aRebootIsAlwaysGood/open-heatpump/documents/code_documentation_html/structDI__STATES__coll__graph.png

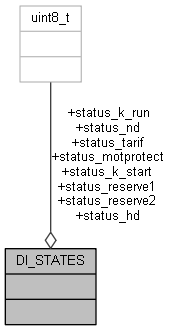
documents/code_documentation_html/structDI__STATES__coll__graph.png
