aRebootIsAlwaysGood/open-heatpump/documents/code_documentation_html/structHEIZKURVE__coll__graph.png

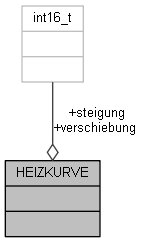
documents/code_documentation_html/structHEIZKURVE__coll__graph.png
