aRebootIsAlwaysGood/open-heatpump/documents/code_documentation_html/structSETTINGS__coll__graph.png

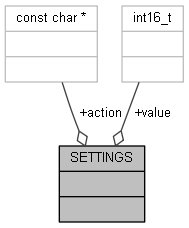
documents/code_documentation_html/structSETTINGS__coll__graph.png
