aRebootIsAlwaysGood/open-heatpump/documents/code_documentation_html/structSYSTEMZUSTAND__coll__graph.png

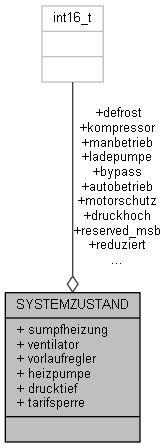
documents/code_documentation_html/structSYSTEMZUSTAND__coll__graph.png
