aRebootIsAlwaysGood/open-heatpump/documents/code_documentation_html/wpAuto_8h_afed4915ead06746e4c683ee93642d8cb_cgraph.png

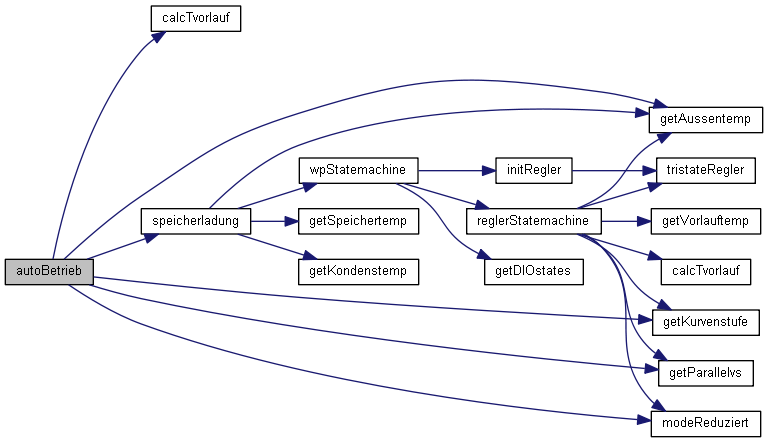
documents/code_documentation_html/wpAuto_8h_afed4915ead06746e4c683ee93642d8cb_cgraph.png
