aRebootIsAlwaysGood/open-heatpump/documents/code_documentation_html/wpControl_8h_ae710165b7dd2b053ad08f96dba48d54c_cgraph.png

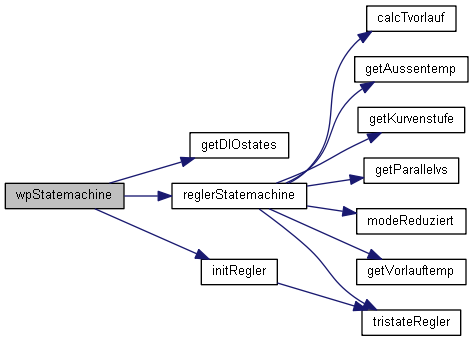
documents/code_documentation_html/wpControl_8h_ae710165b7dd2b053ad08f96dba48d54c_cgraph.png
