aRebootIsAlwaysGood/open-heatpump/documents/code_documentation_html/wpMain_8ino_afe461d27b9c48d5921c00d521181f12f_cgraph.png

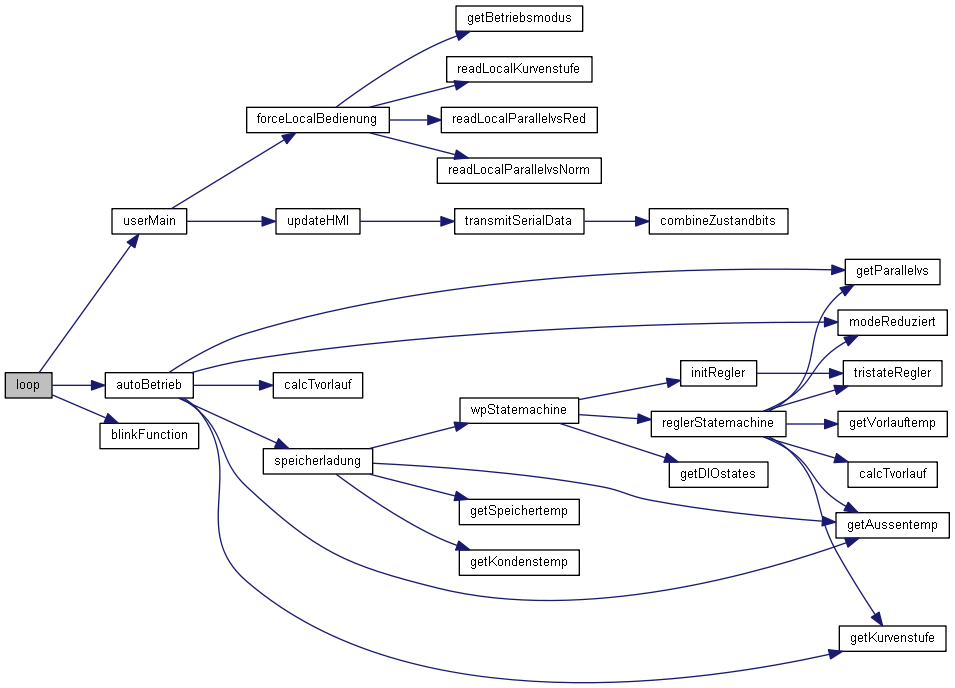
documents/code_documentation_html/wpMain_8ino_afe461d27b9c48d5921c00d521181f12f_cgraph.png
