aRebootIsAlwaysGood/open-heatpump/documents/code_documentation_html/wpRegler_8h_a802a6ca104db722b268f0693497b7094_cgraph.png

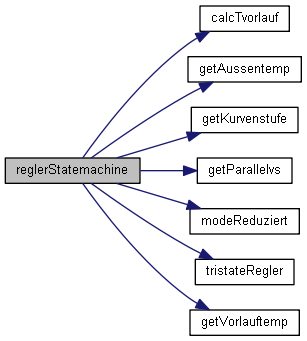
documents/code_documentation_html/wpRegler_8h_a802a6ca104db722b268f0693497b7094_cgraph.png
