aRebootIsAlwaysGood/open-heatpump/documents/code_documentation_html/wpSpeicherladung_8h_a1c0cf0ef9357ae514777ada14e9a8edd_cgraph.png

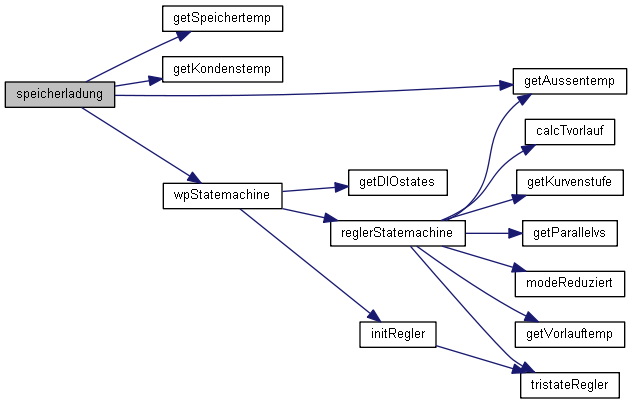
documents/code_documentation_html/wpSpeicherladung_8h_a1c0cf0ef9357ae514777ada14e9a8edd_cgraph.png
