aRebootIsAlwaysGood/open-heatpump/documents/code_documentation_html/wpUser_8h_a805e7a62053643fc56378e3905329b2b_cgraph.png

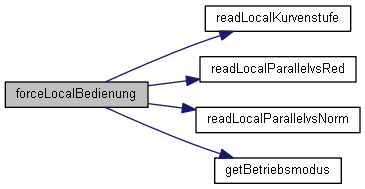
documents/code_documentation_html/wpUser_8h_a805e7a62053643fc56378e3905329b2b_cgraph.png
