aRebootIsAlwaysGood/open-heatpump/documents/code_documentation_html/wpUser_8h_ab3d6a2608aa113517ff811539024869a_cgraph.png

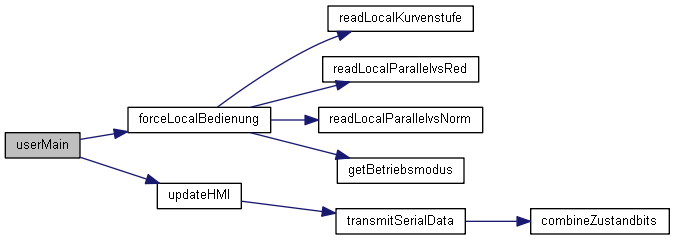
documents/code_documentation_html/wpUser_8h_ab3d6a2608aa113517ff811539024869a_cgraph.png
