aRebootIsAlwaysGood/open-heatpump/documents/Schema_Grundsteuerung_SW.pdf

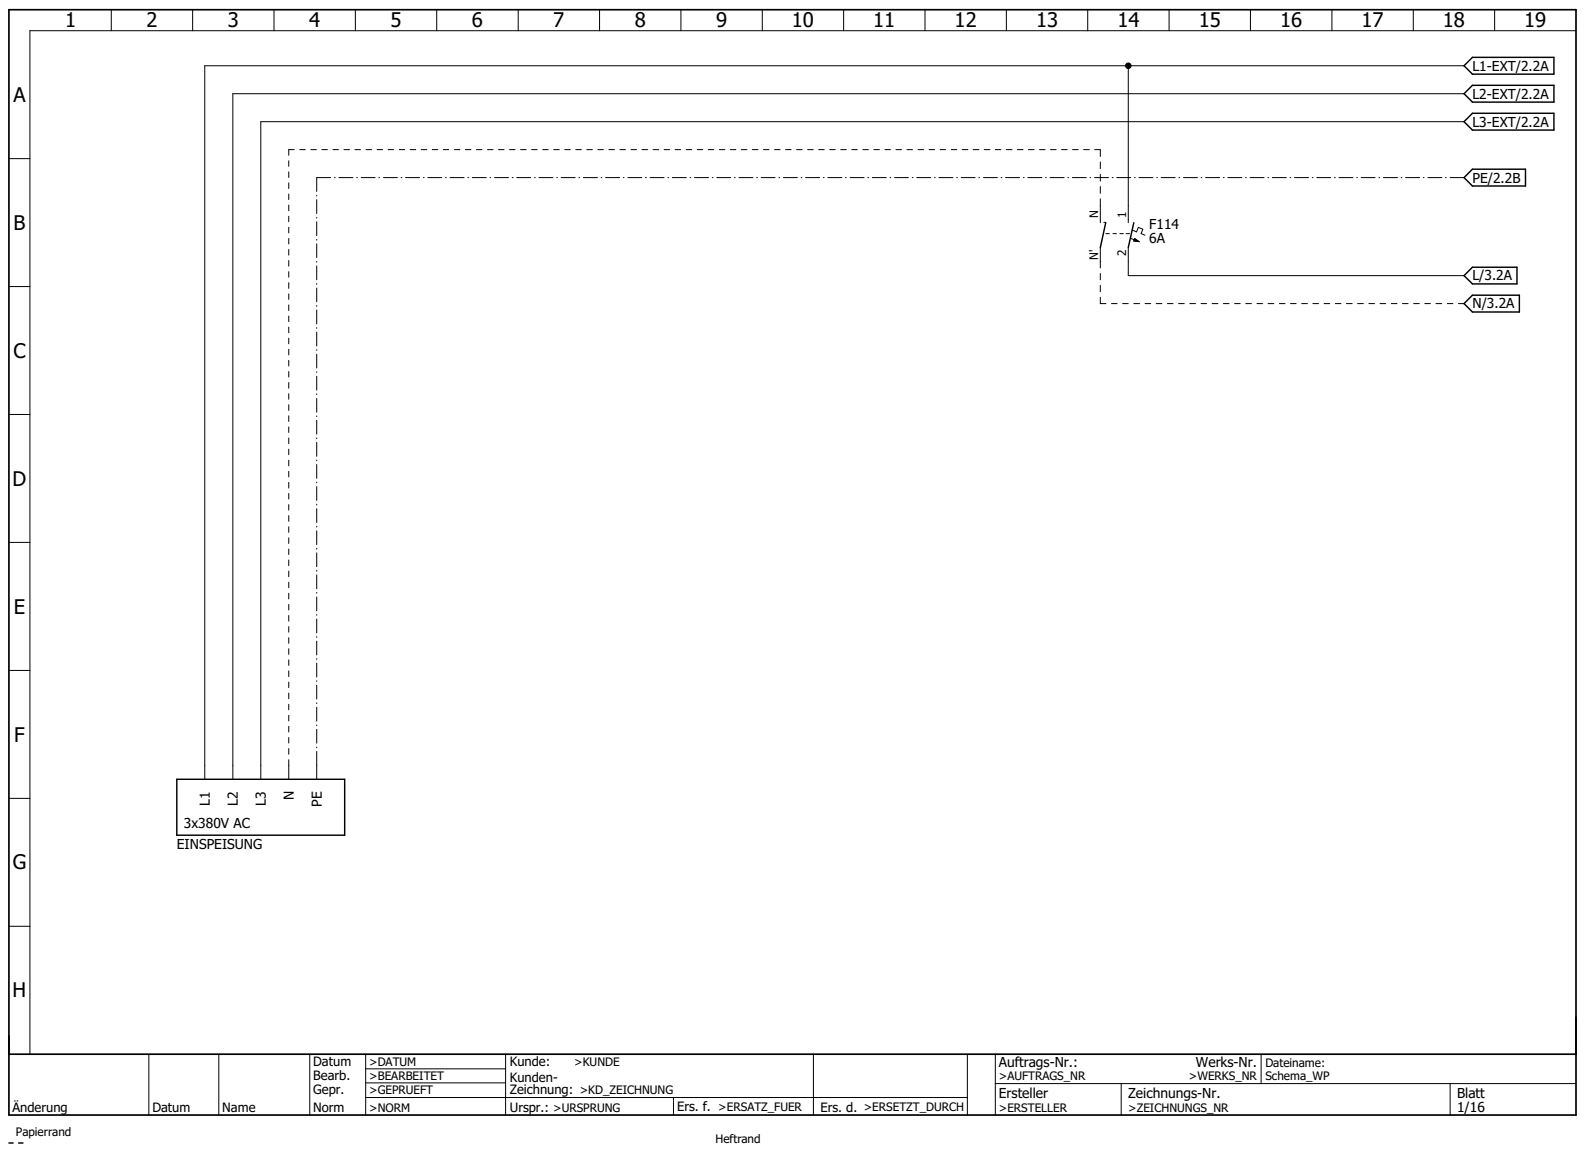
[picture p32: page 1]

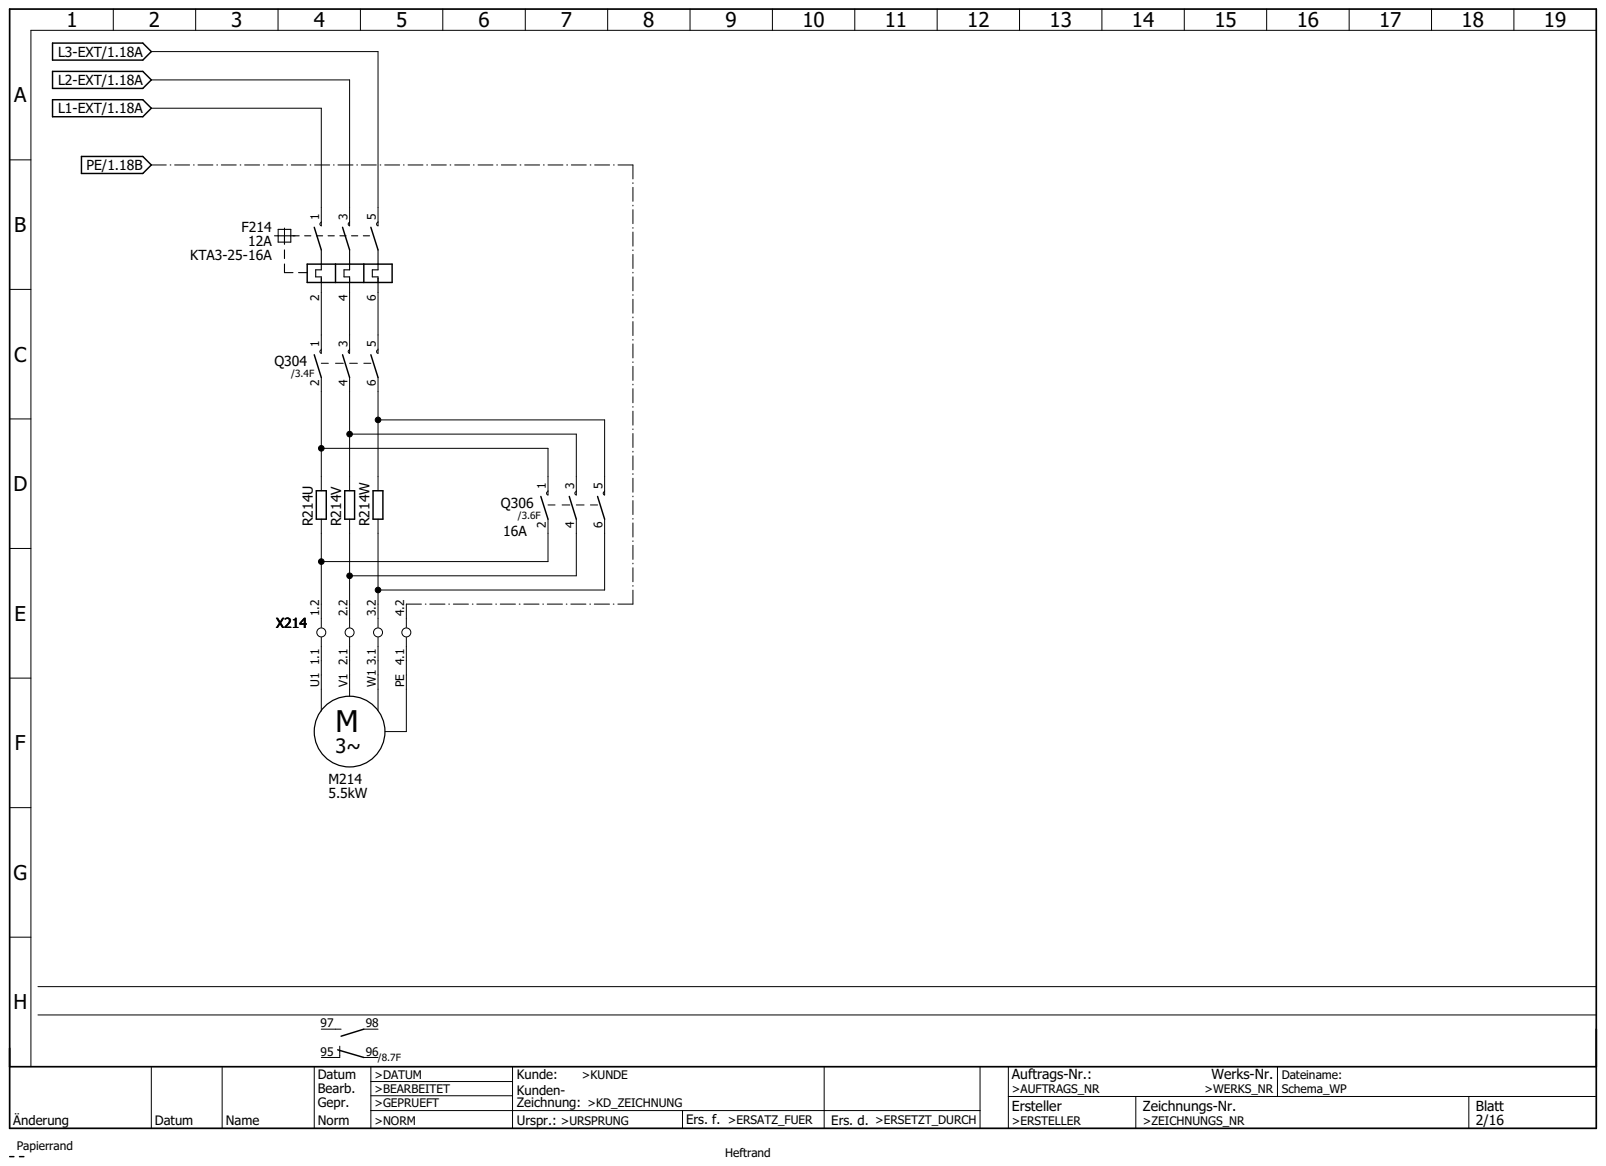
[picture p33: page 2]

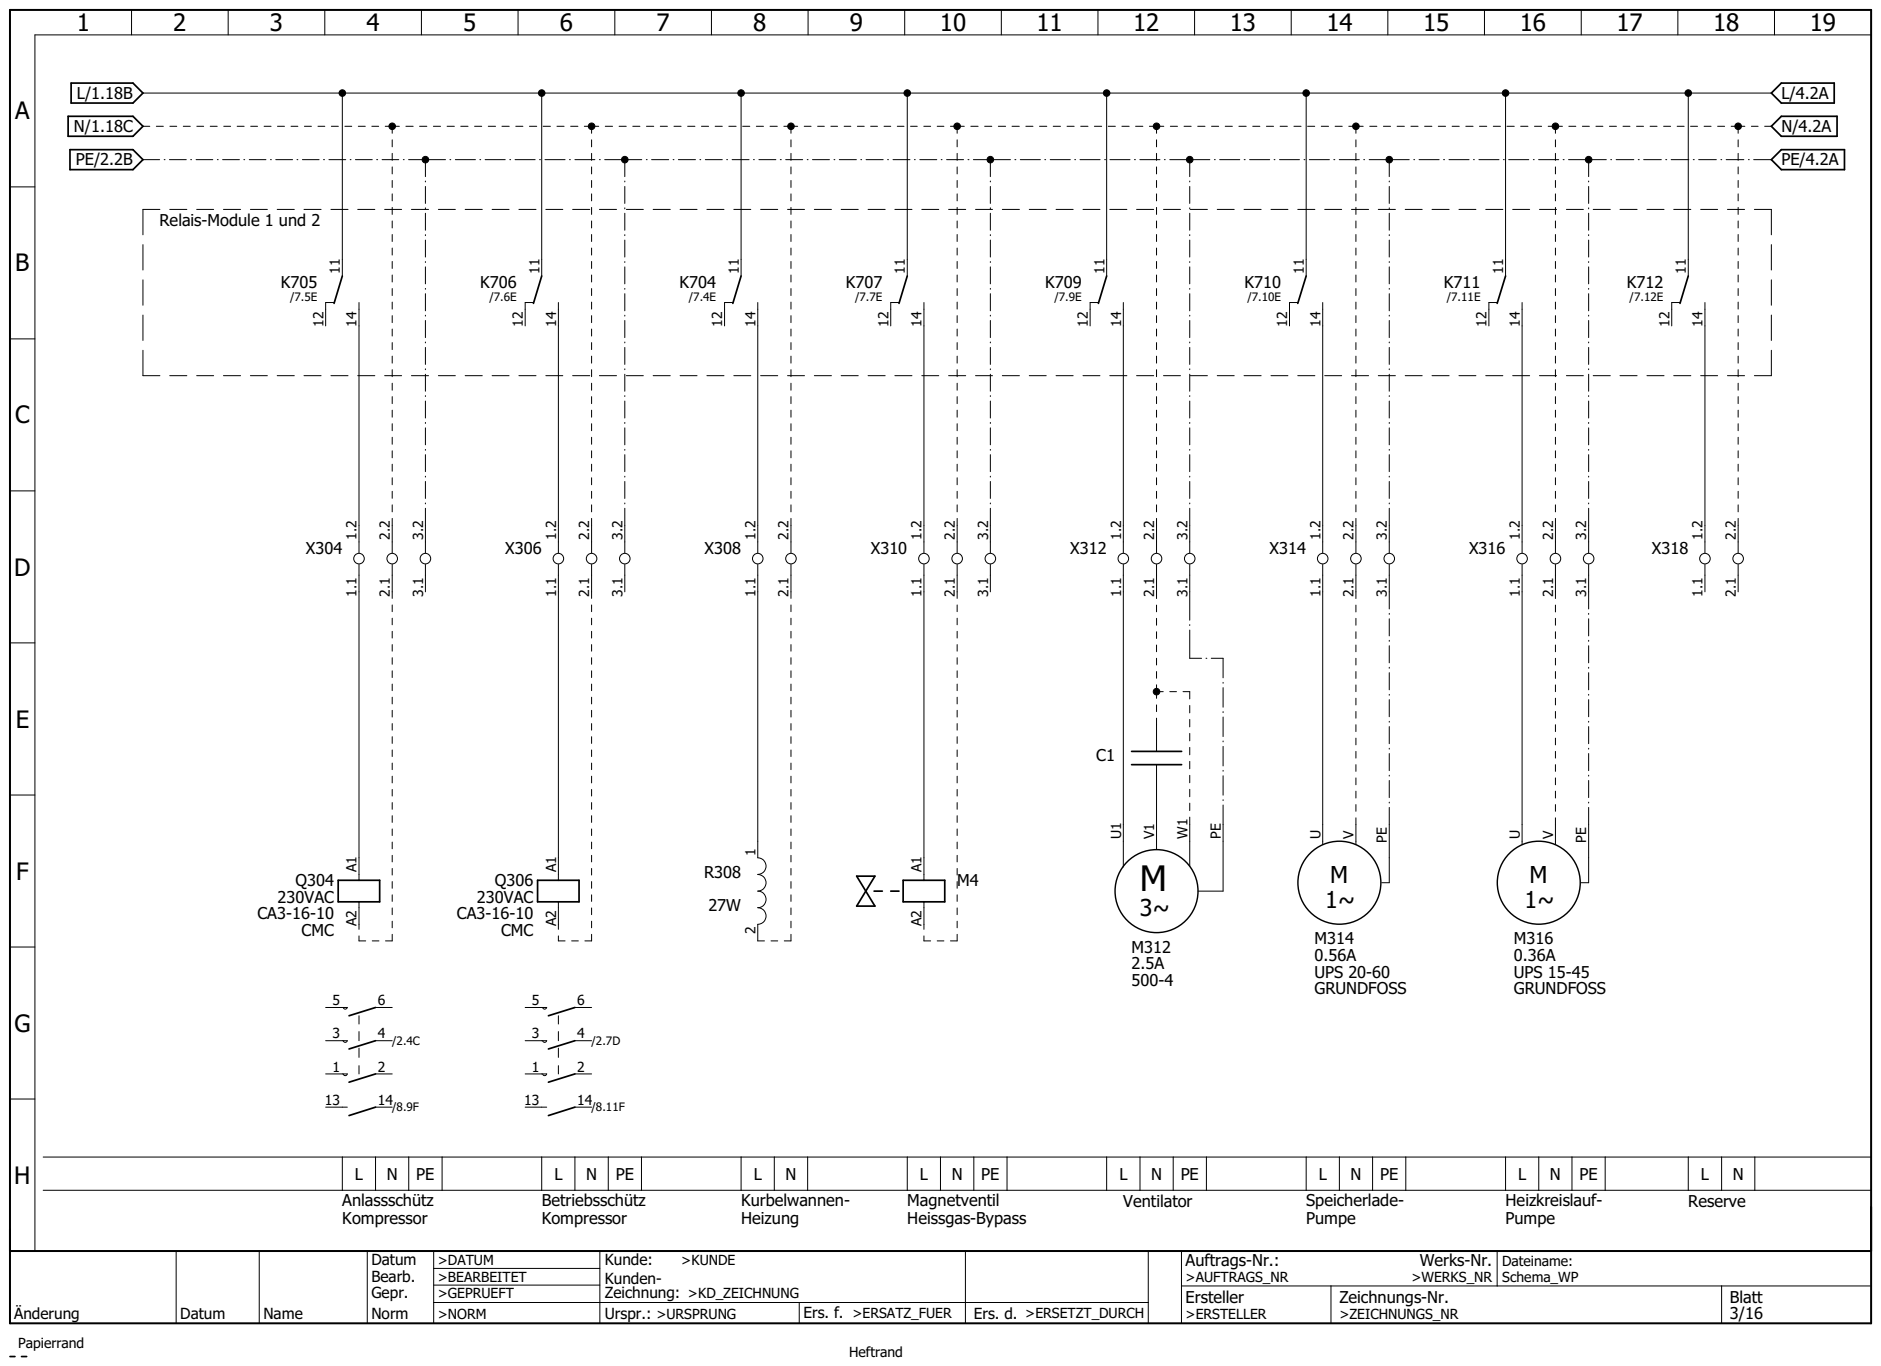
[picture p34: page 3]

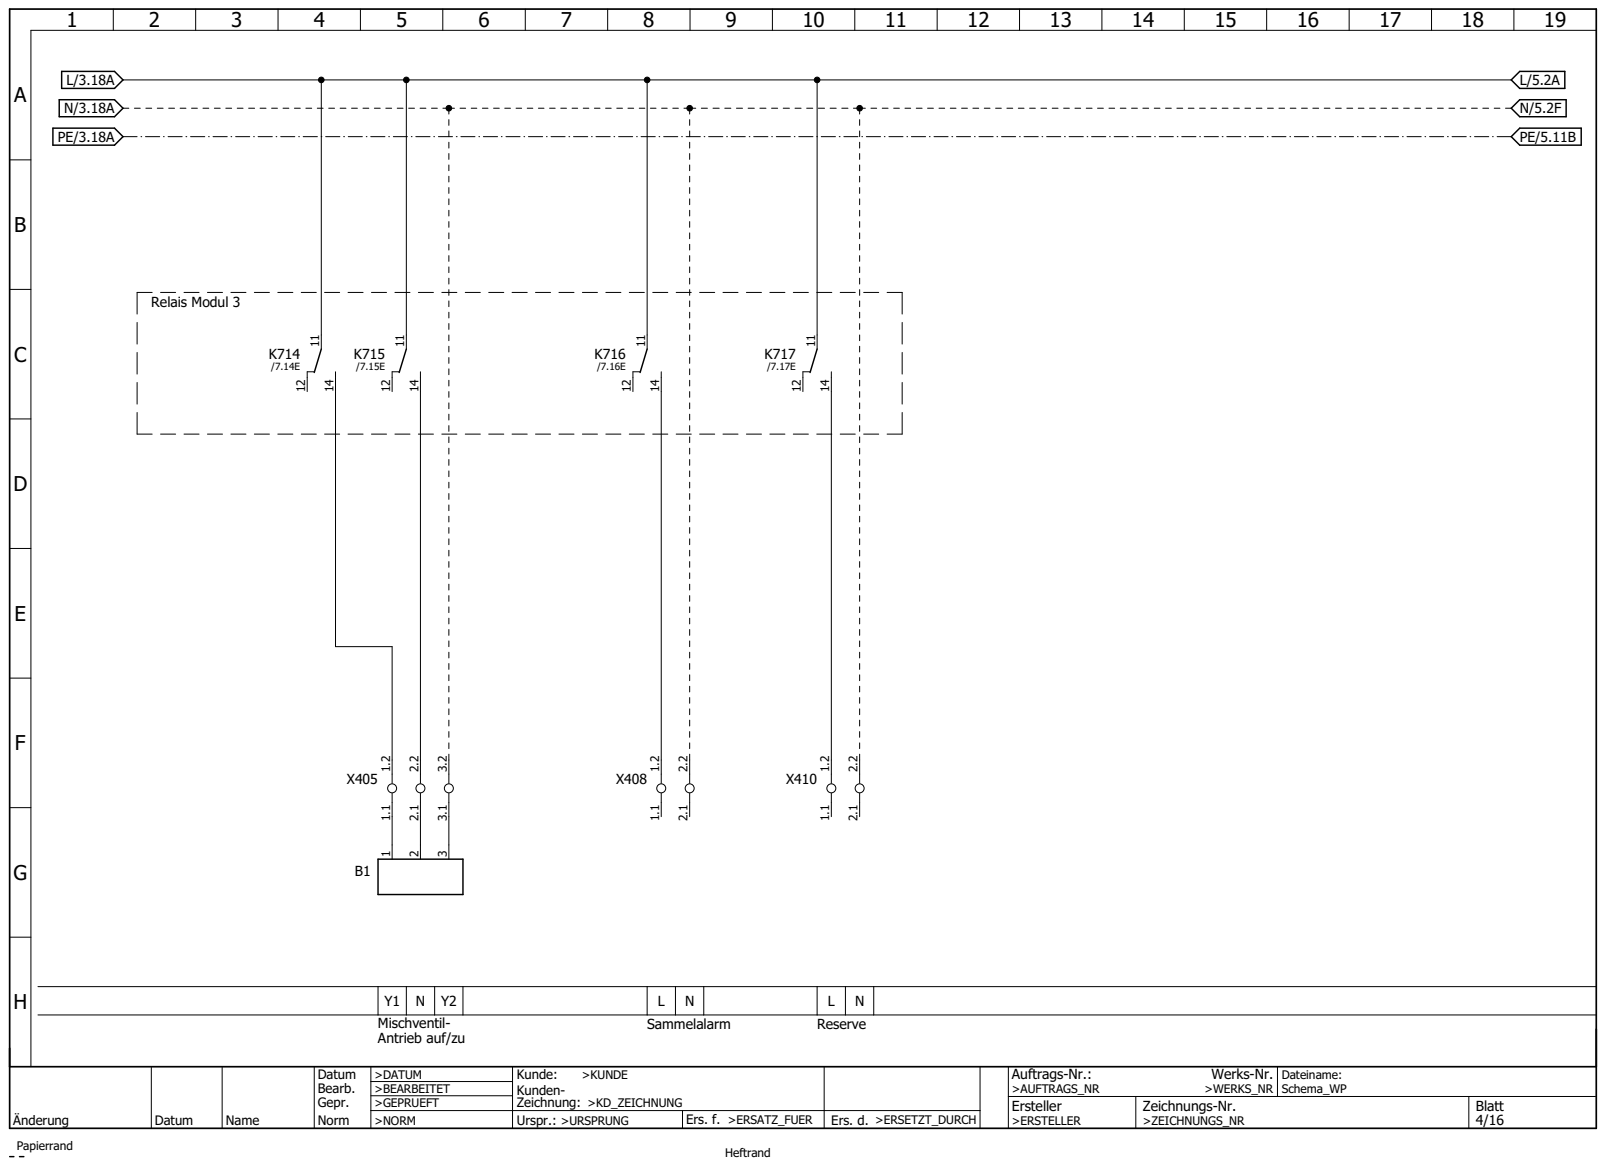
[picture p35: page 4]

Mischventil- Antrieb auf/zu

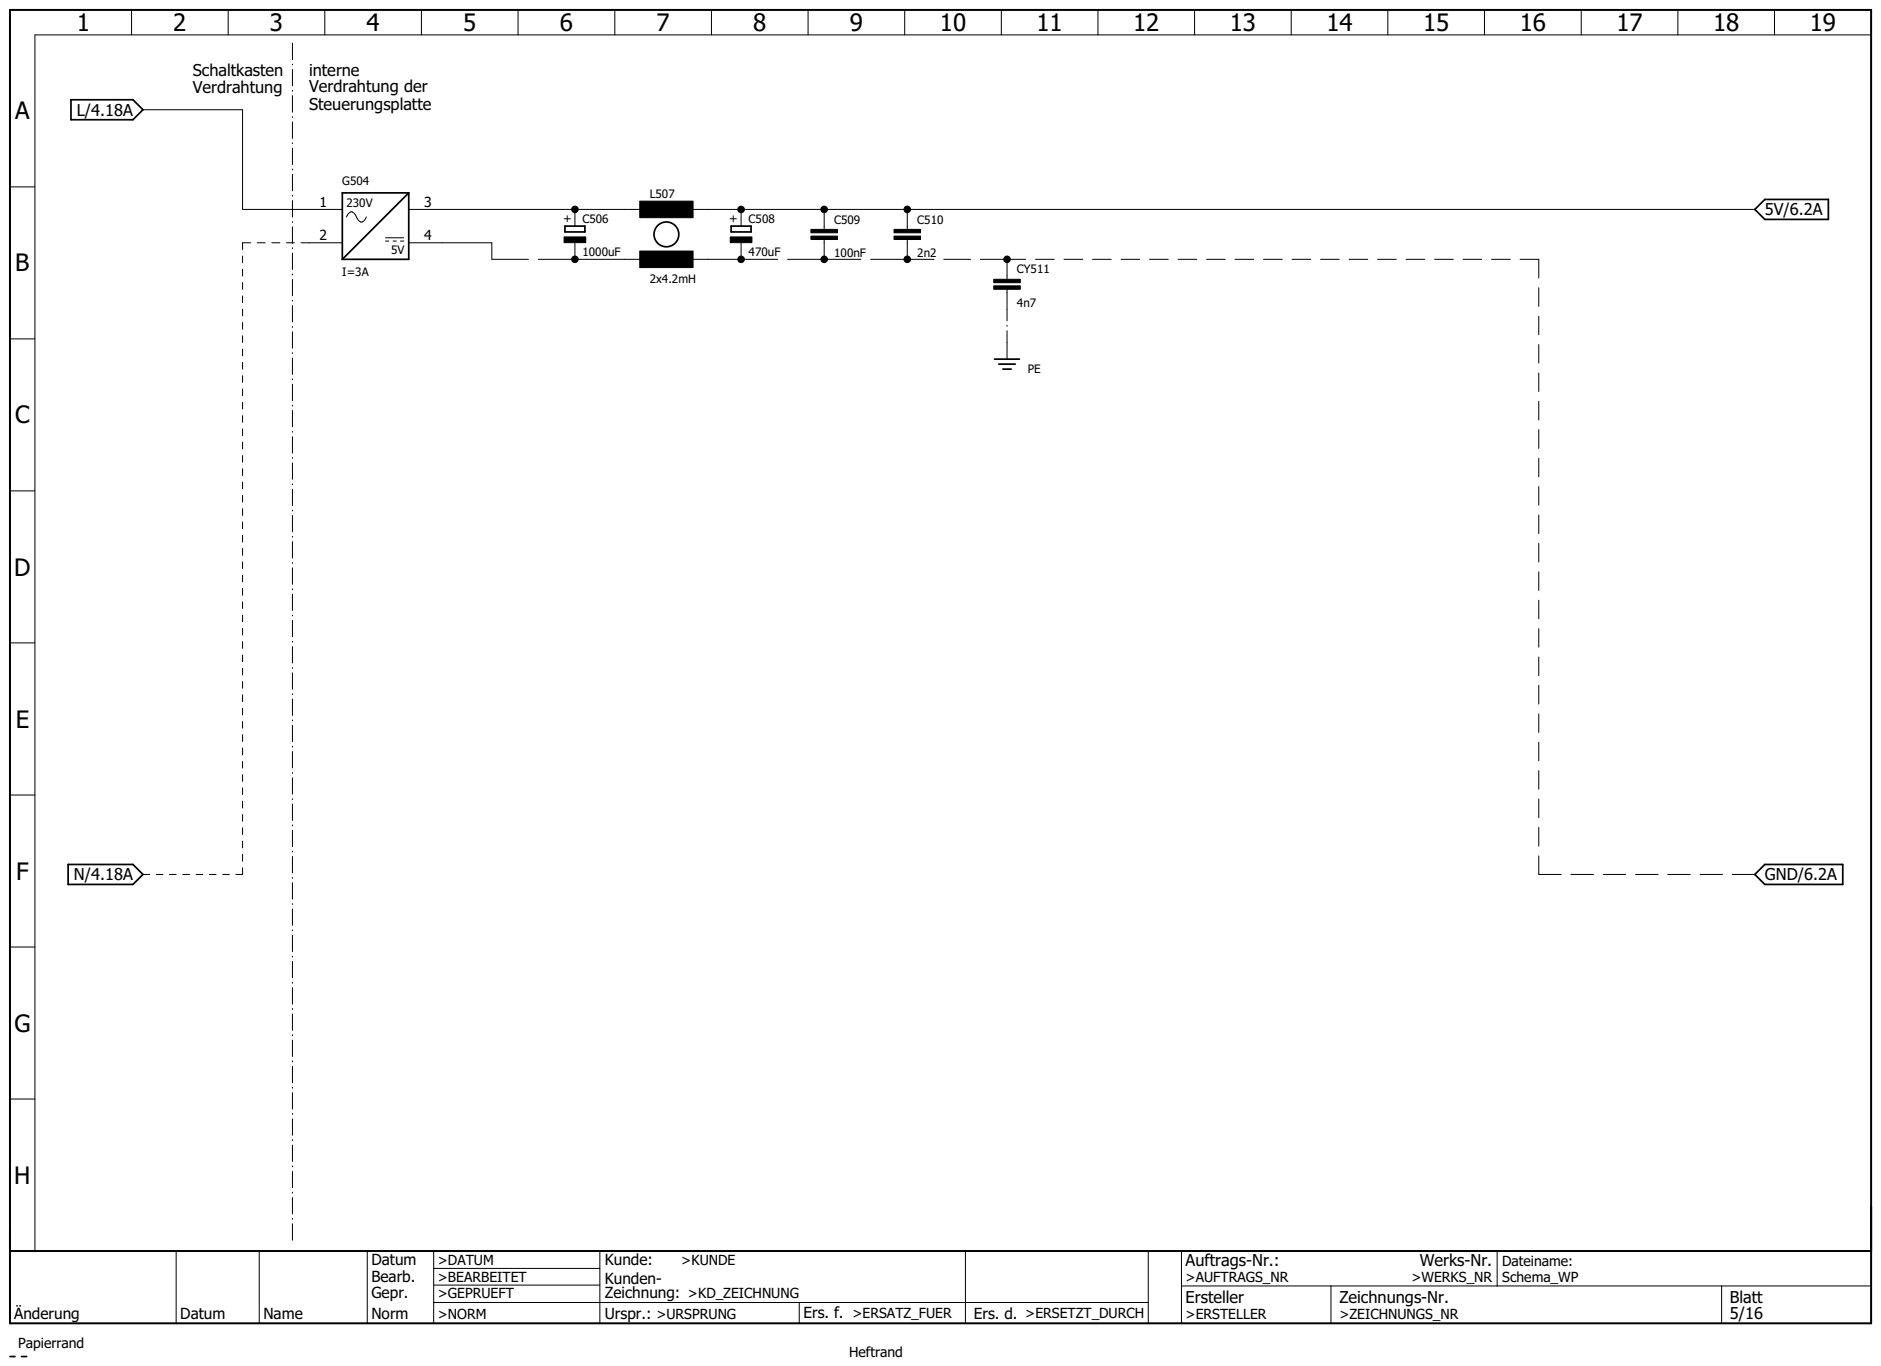
[picture p36: page 5]

interne Verdrahtung der Steuerungsplatte Schaltkasten Verdrahtung

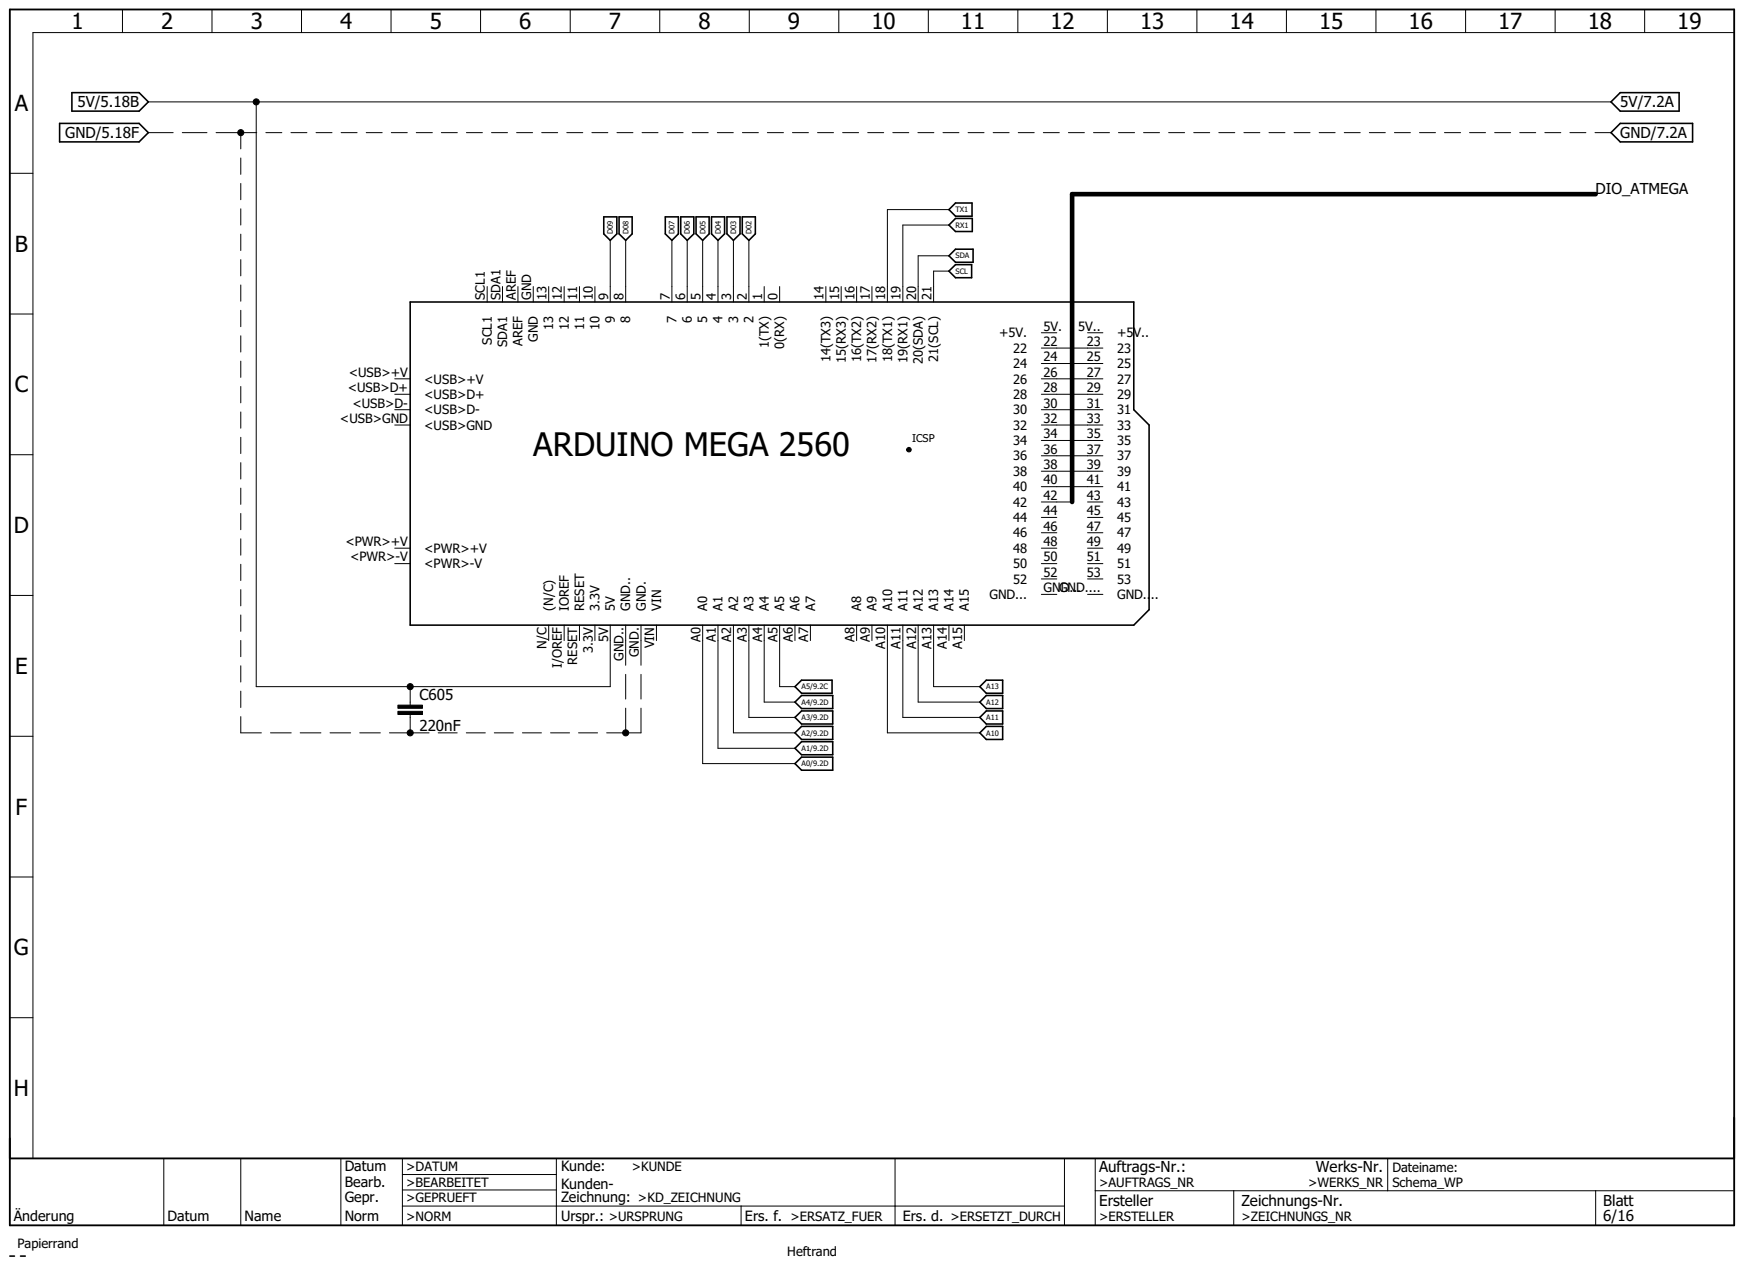
[picture p37: page 6]

GND. GND. GND.. GND.. 5V

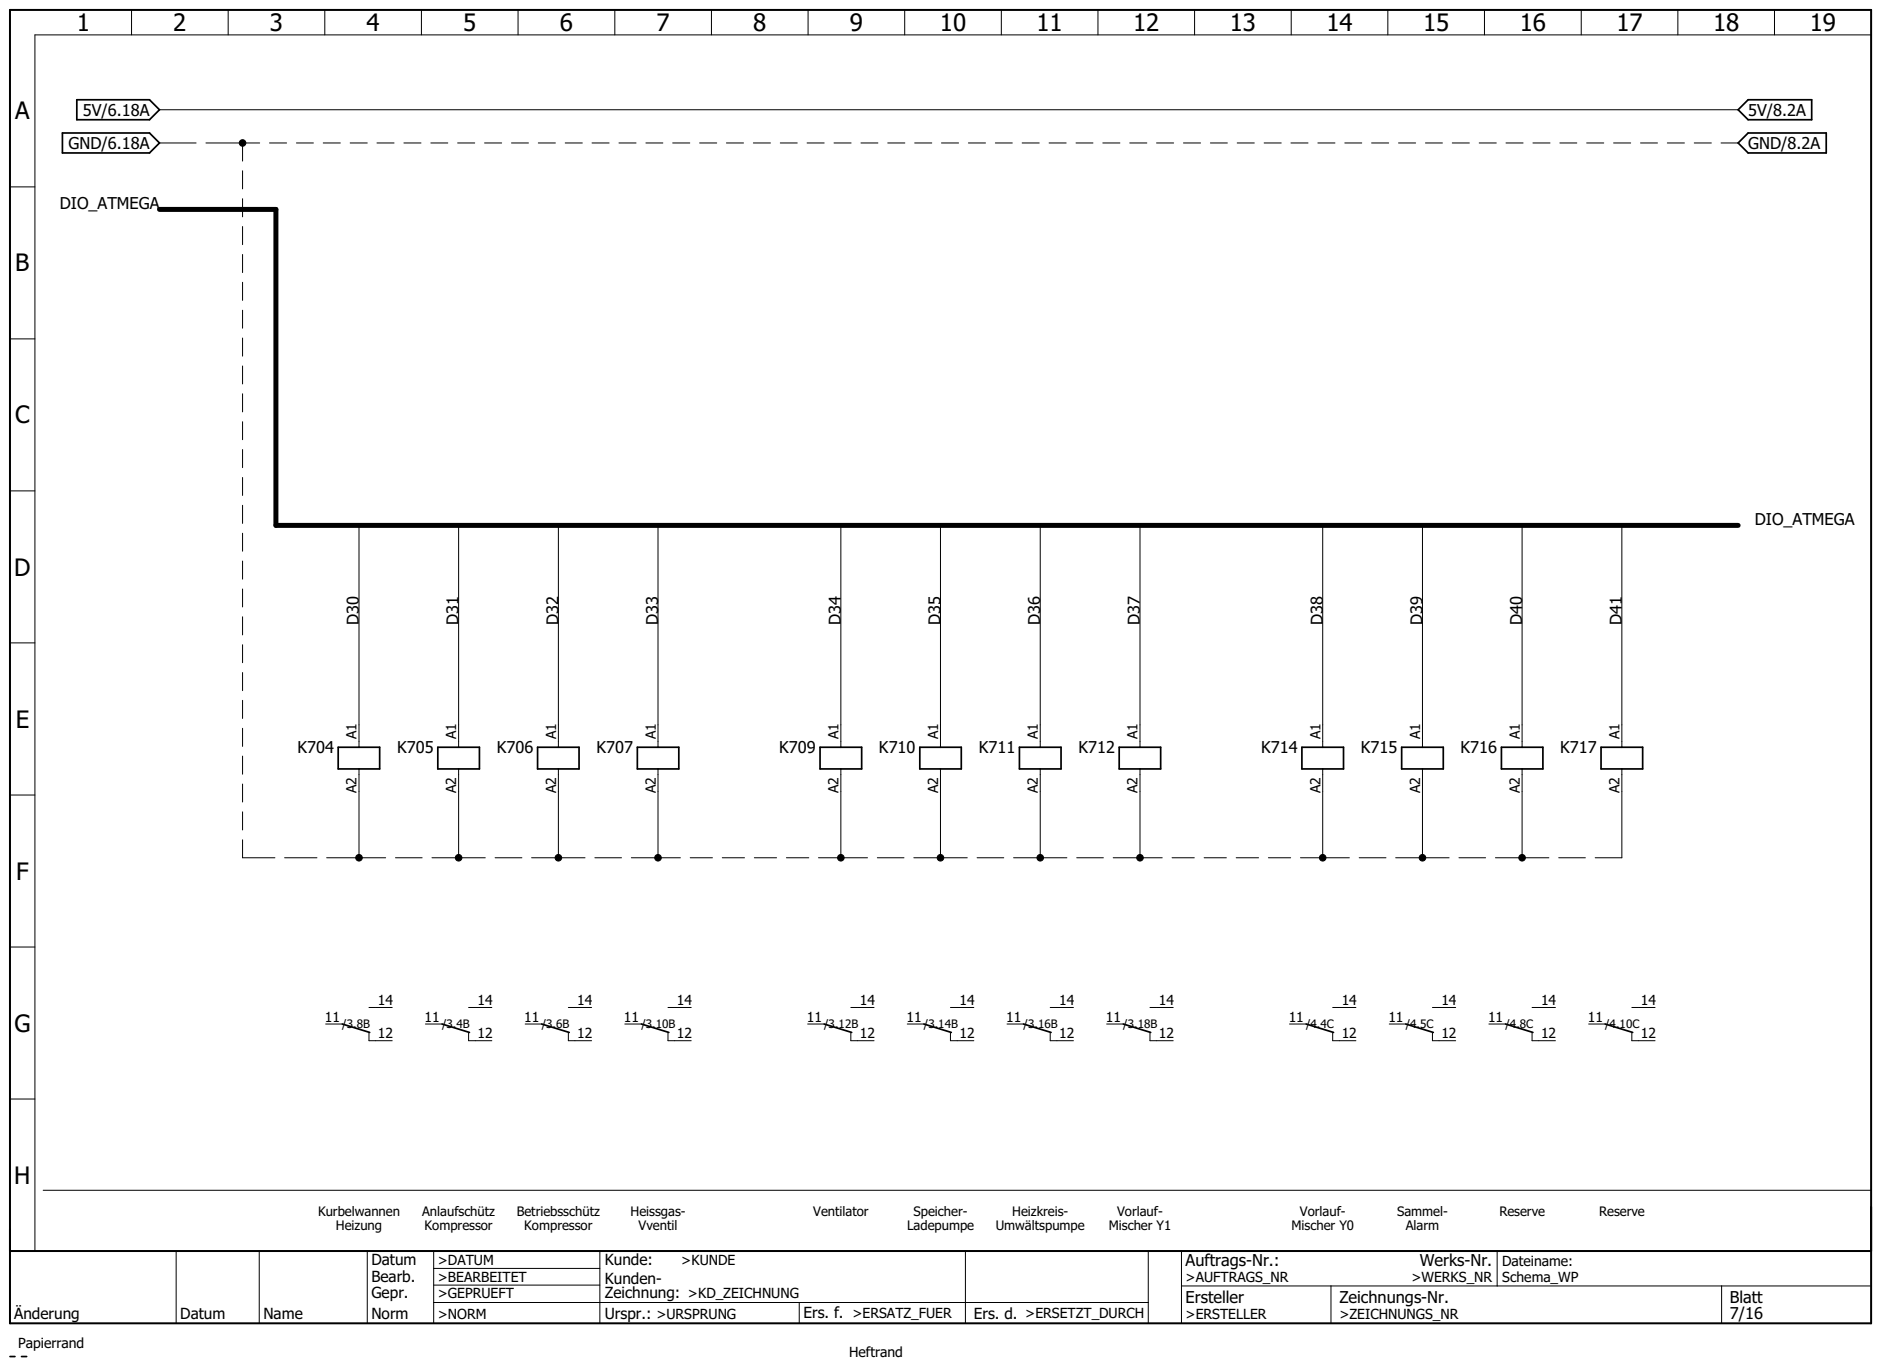
[picture p38: page 7]

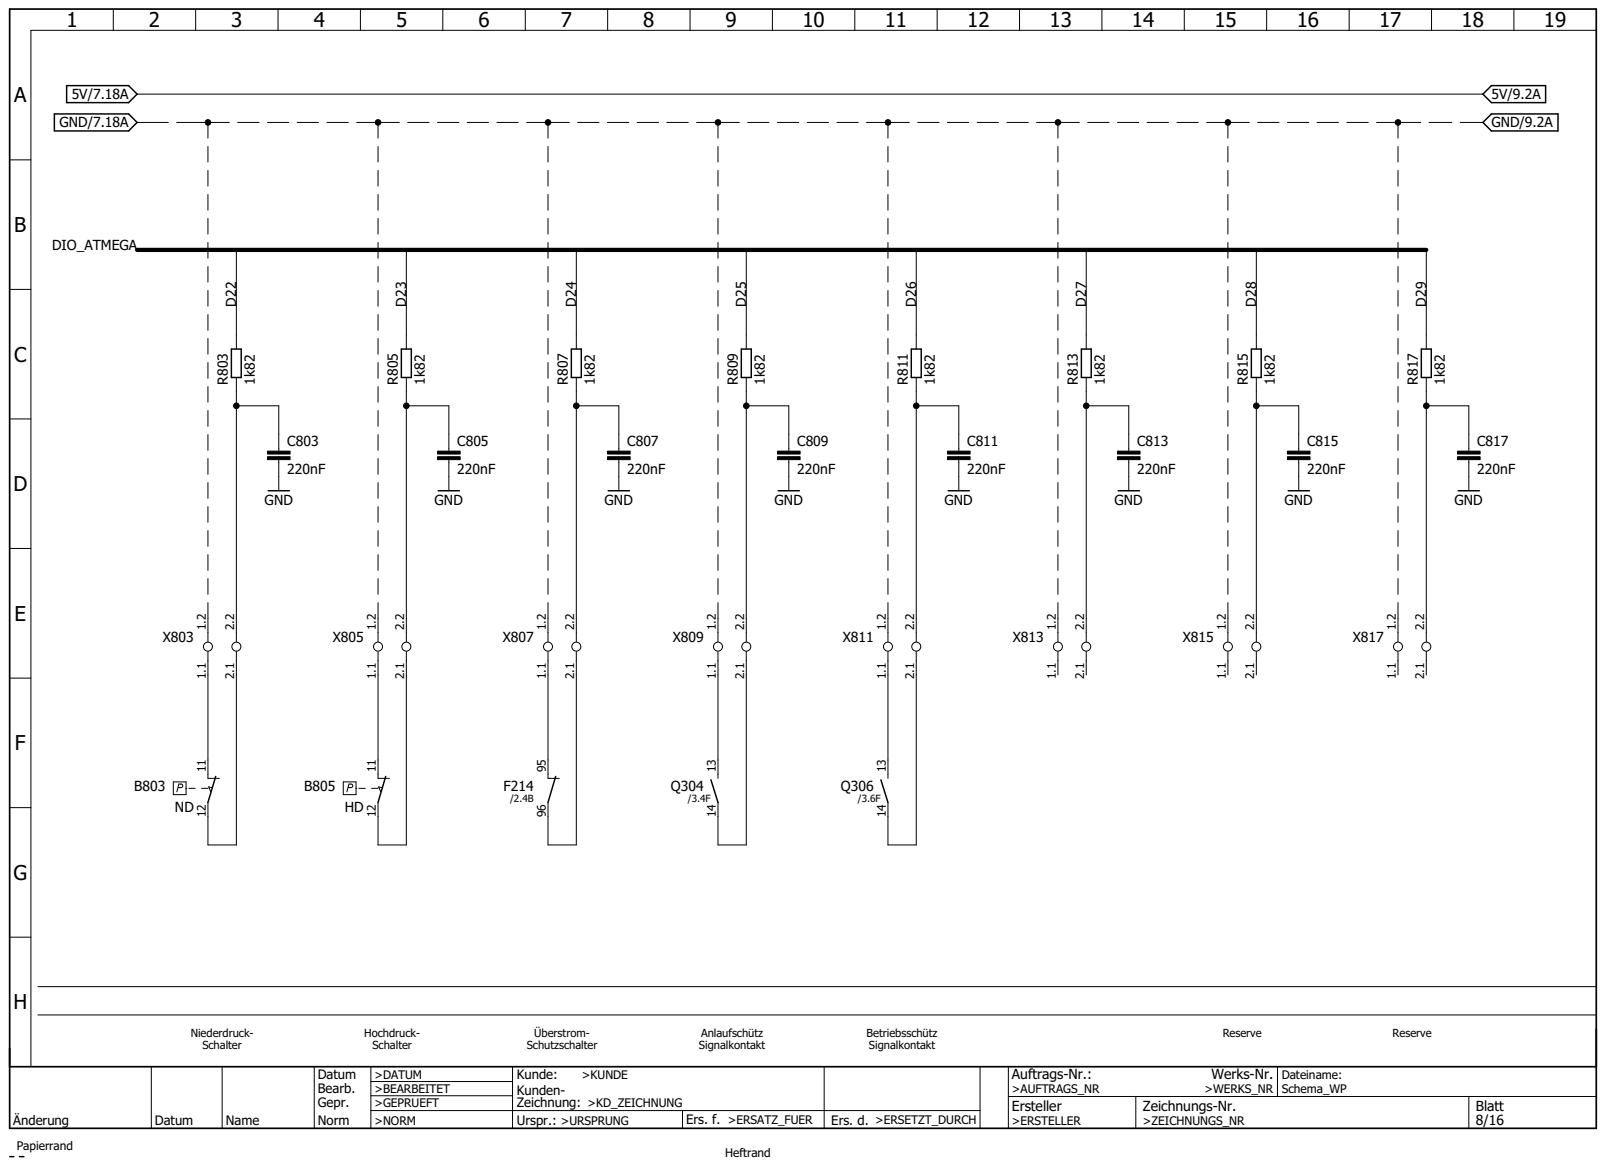
[picture p39: page 8]

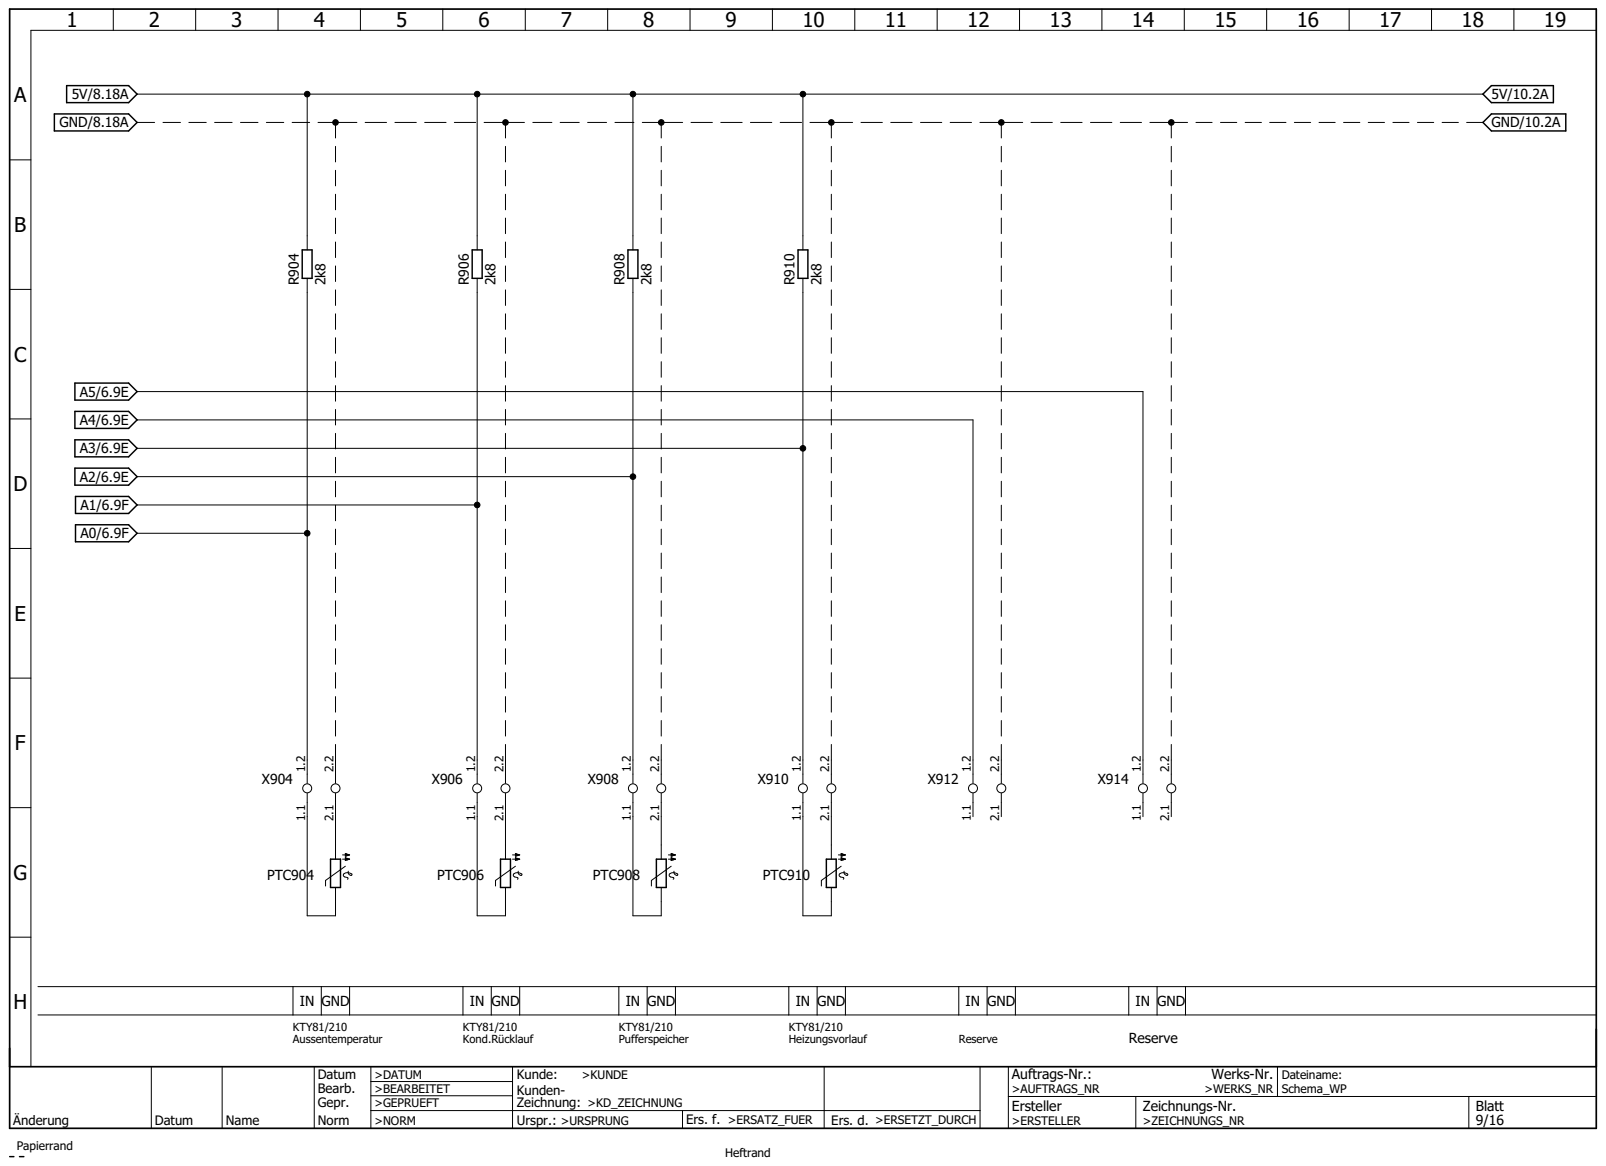
[picture p40: page 9]
