aRebootIsAlwaysGood/open-heatpump/documents/Hydraulikschema.pdf

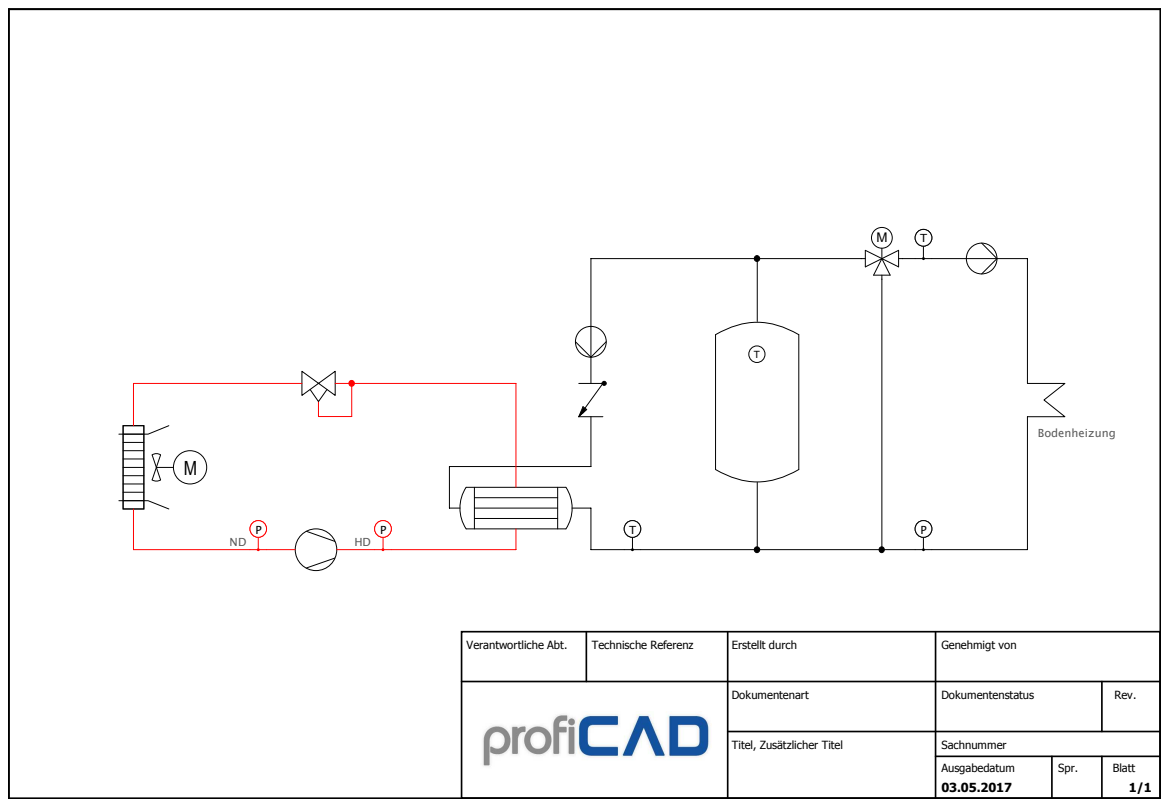
[picture p41: page 1]
Bodenheizung; Verantwortliche Abt.; Technische Referenz; Erstellt durch; Genehmigt von

Dokumentenart | Dokumentenstatus | Rev.

Titel, Zusätzlicher Titel | Sachnummer

Ausgabedatum 03.05.2017 | Spr. | Blatt 1/1
