aRebootIsAlwaysGood/open-heatpump/wpSpeicherladung.ino

/**
 *  @file wpSpeicherladung.ino
 *  @brief Aufladen des Pufferspeichers.
 *
 *  @author Daniel Schmissrauter
 *  @date 	09.01.2018
 */

 #include "wpSpeicherladung.h"
 /************************************************************************/
 /**
 *	@brief Führt die Speicherladung und Abtauung mittels Zustandsautomat durch.
 *
 * Kontrolliert die Speichertemperatur und hält sie stets oberhalb der
 * Vorlauftemperatur durch initiieren eines Ladevorgangs. Die Funktion steuert
 * ausserdem den Abtauvorgang und leitet ihn in Abhängigkeit von Laufzeit und
 * Aussentemperatur selbständig ein. Die Richtwerte entstammen aus
 * Fachliteratur. \n
 * Untenstehend sind die Überlegungen in Notizform niedergeschrieben: \n
* Stufenladung Speicher monovalent RAVEL Empfehlung: Siehe RAVEL
* Standardschaltungen S16
* Temperaturdiff über Verflüssiger = 0.5...0.7*Tempdiff VL/RL im
* Auslegepunkt(45-35=10°C) = 5°C
* -> Ausschalten WP wenn Tkondensatorrücklauf - Tspeicher < 5...7°C
*  -->witterungsgeführtes Ausschalten: (Tspeicher - Tkond) < 5°C && Tkond < 46°C
* Einstellregeln: \n
*1. Speichertemp bei WP-Start(Einschalttemp) <= Speichertemp bei
* WP-Stop(Ausschalttemp)
* 2. Ausschalttemp <= max. zul. Verflüssiger-Austrittstemp - max Tempdiff über
* Verfl. -> 50*C - (5...7°C) = 45°C (max Heizanforderung)
* 3. Bedingung: Einschalttemp >= max. auftretende Rücklauftemp
*      -> Ton >= (Tvorlauf-Tempdiff_Heizung) falls > Tspeicher
* -Festlegen max zul. Verflüssigeraustrittstemp auf <=50°C (R502)
*	ND: 2bar= -19°C, HD: 26bar= 60°C, Verflüssiger Pmax: 28bar= 64°C
* -Vor-&Nachlauf Ladepumpe normalerweise unnötig
* -Tempdiff über Verbraucher: 10K
*
* @param t_vorlaufsoll
*       Berechnete Vorlauf-Solltemperatur.
*/
/************************************************************************/
 void speicherladung(float t_vorlaufsoll){

	 static uint32_t laufzeit;
	 uint32_t defrostzeit= 180000; // Enteisungszeitdauer abhängig von Aussentemp
	int16_t tregel= int(t_vorlaufsoll); // Umwandlung Float zu signed int
    // int16_t tvorlauf= getVorlauftemp(); // gemischt (unused)
	 int16_t tspeicher= getSpeichertemp(); // Speicher Einlaufbereich= erwärmt
	 int16_t tkondens= getKondenstemp(); // Kaltwasser vor Erwärmung
	 int16_t taussen= getAussentemp();

	 // Einschaltbedingung (Tspeicher > Tmax_rücklauf) festlegen
      int16_t tmax_ruecklauf= tregel;
	 if (tregel >40){
		 tmax_ruecklauf -= 5; // Falls berechnete Vorlauftemp > 40, dann -5
	 }
	 else if (tregel>36){
		 tmax_ruecklauf -= 4;
	 }
	 else if (tregel>32){
		 tmax_ruecklauf -= 3;
	 }
	 else if (tregel>28){
		 tmax_ruecklauf -= 2;
	 }
	else{
		 tmax_ruecklauf -= 1;
	 }

	// setze Enteisungsdauer fest
	if (taussen <= TEMP_DEFROST_REQUIRED){
		if (taussen < 7){
			defrostzeit= 180000; // 3min bei Ta über +7°C
		}
		else if (taussen < 2){
			defrostzeit= 360000; // 6min bei Ta zwischen +3...7°C
		}
		else{
			defrostzeit= 720000;	// 12min bei Ta unter +3°C
		}
	}

	switch (ladenState)
		{
		case LADEN_STATE_IDLE:
            wpStatemachine(WP_REQ_FUNC_IDLE);
			// Einschaltbedingung prüfen(Speichertemp höher als Rücklaufmax oder unterhalb Sollvorlauftemp -> Inbetriebname!
            laufzeit= millis(); // Startzeit festhalten
			 if ((tspeicher >= tmax_ruecklauf) || (tspeicher < tregel)){
				 ladenState= LADEN_STATE_LADEN;
			}
			break;

		case LADEN_STATE_LADEN:
            wpStatemachine(WP_REQ_FUNC_LADEN);
			// max Verflüssigertemp - 0.5*Tempdiff über Verflüssiger Auslegepunkt zu hoch
			if ((tspeicher> 48) || (tkondens > 45)){
				ladenState= LADEN_STATE_STOP;
			}

			 // Ausschaltbedingung (Speicher bis unten warm)
			 // Bedingung 1: Speichertemp > 15°C ansonsten zu Beginn Heizperiode ständiges aus
			 else if ((tspeicher > tmax_ruecklauf) && ((tkondens- tregel)>=5)){
				 // Anschliessende Enteisung falls Aussentemp kritisch
				 if (taussen<= TEMP_DEFROST_REQUIRED){
					 ladenState= LADEN_STATE_DEFROST;
					 laufzeit= millis();
				 }
				 else{
					 ladenState= LADEN_STATE_STOP;
				 }
			 }

			// falls Vereisungsgefahr Laden pausieren um zu Enteisen, ansonsten Timerreset
			else if ((millis()-laufzeit)> T_MAX_LADEN){
				 if (taussen<= TEMP_DEFROST_REQUIRED){
					 ladenState= LADEN_STATE_DEFROST;
                     laufzeit= millis();
				 }
				 else{
					 laufzeit= millis();
				 }
			}
			break;

		case LADEN_STATE_STOP:
			// Laden beenden, Sperrzeit initiieren
			wpStatemachine(WP_REQ_FUNC_HALT);
			laufzeit= millis();
			ladenState= LADEN_STATE_GESPERRT;
			break;

		case LADEN_STATE_DEFROST:
            wpStatemachine(WP_REQ_FUNC_DEFROST);
			// Enteisen bis Defrostzeit abgelaufen
			if ((millis()-laufzeit) > defrostzeit){
				ladenState= LADEN_STATE_STOP;
			}
			break;

		case LADEN_STATE_GESPERRT:
            wpStatemachine(WP_REQ_FUNC_IDLE);
			// Warten bis Sperrzeit abgelaufen
			if((millis()-laufzeit)> T_WIEDERANLAUFSPERRE){
				ladenState= LADEN_STATE_IDLE;
                laufzeit= millis();
			}
			break;

	}
    // only for debugging
    #ifdef DEBUG_PROGRAM_FLOW
        Serial.print(F("Executed: speicherladung"));
        Serial.println(F(" ->Modul: Speicherladung"));
    #endif
}
