aRebootIsAlwaysGood/open-heatpump/(commit log)

2018-02-08 Corrected Pressure Switch Signal handle, Inverted Bypass Output Policy, Added LCD, Encoder and Menu Prototype
    [wpControl.ino, wpMain.h, wpMain.ino, wpSensorik.h, wpSpeicherladung.ino, wpUser.h, wpUser.ino]
2018-02-22 Added functions for local User-IO and usersettings update. Improved TX/RX UART functions.
2018-02-28 Changed buttons to analoginput to free up more outputs for userindicators. Added function to send periodical data to HMI
2018-03-02 Added debugmessages which print out the actual function on serialmonitor.
2018-03-02 Updated pinnumbers, corrected inverted motorprotection-signal, normalized HD/ND check to DiStates
    [wpControl.ino, wpMain.h, wpMain.ino, wpUser.ino]
2018-04-12 Alot of small corrections and changes.
    [wpAuto.ino, wpControl.ino, wpMain.h, wpMain.ino, wpRegler.ino, wpSensorik.ino, wpSpeicherladung.ino, wpUser.ino]
2018-04-14 Fixed exec temp.& low-lvl control in switch cases. Lots of small changes & fixes
    [wpControl.h, wpControl.ino, wpMain.h, wpMain.ino, wpRegler.ino, wpSensorik.ino, wpSpeicherladung.ino, wpUser.ino]
2018-04-15 Fix: Bitshift Systemstatus, Pressure indicator
    Added a better way to shit binary states into integer value.
    Pressure indicator works now again.
    [wpUser.ino]
2018-04-15 Fix: Statusbit of temperature controller
    Remove: not used defrost modul since its integrated into wpSpeicherladung
    [wpControl.ino, wpMain.ino, wpRegler.ino]
2018-07-04 Added documentation, schematics
